cerber-os/MegaLeaf/README.md

# MegaLeaf - next level RGB lightning

## Overview

## Microcontroller

## Userspace software
