cerber-os/MegaLeaf/mcu_esperif/main/cfg/Readme.txt

Put here onboarding_cfg.json and device_info.json dowloaded from your project page on Samsung SmartThings Worspace.
