cerber-os/MegaLeaf/board/MegaLeafPCB.kicad_pcb

## KiCad design board/MegaLeafPCB.kicad_pcb (2022-11-14)

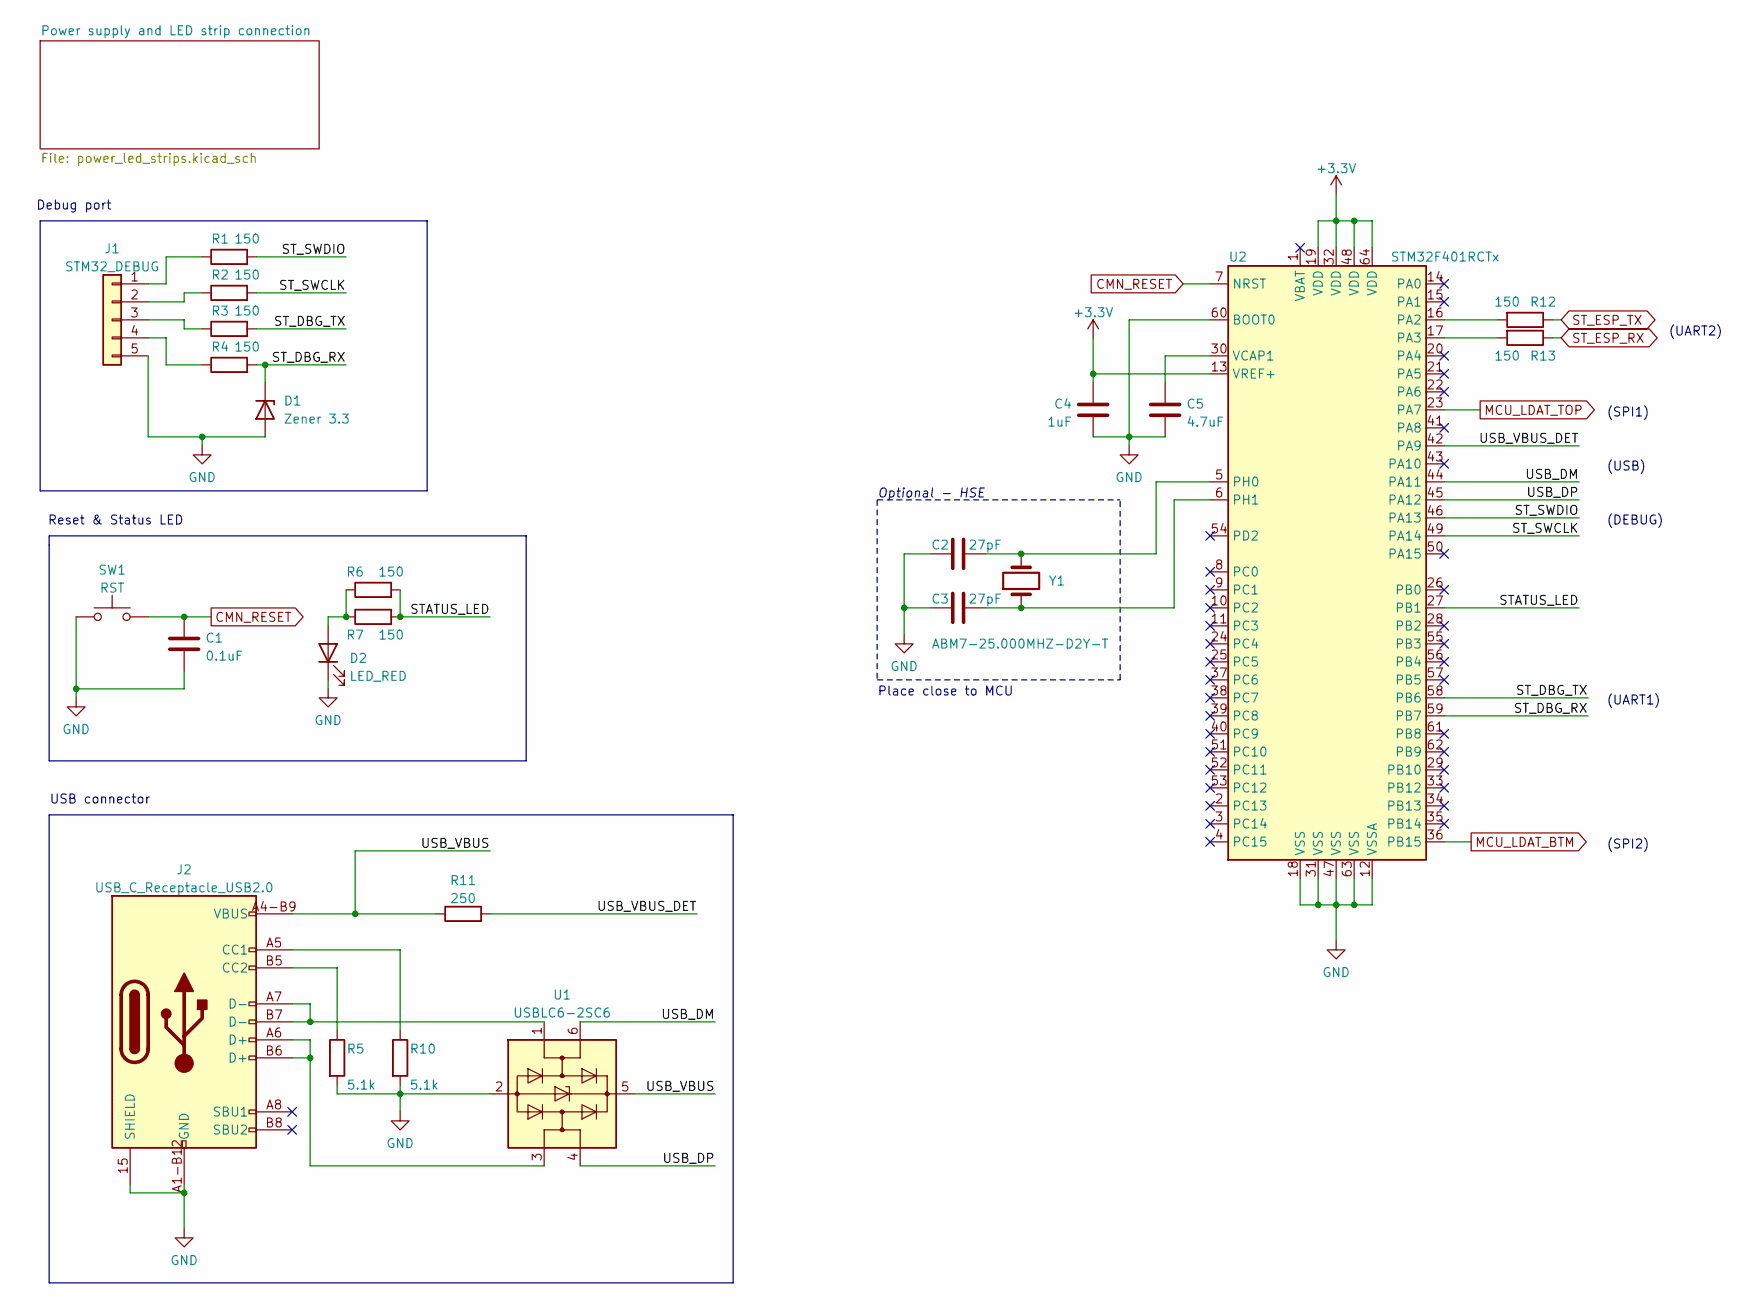
[picture p6: schematic MegaLeafPCB.kicad_sch, MegaLeaf Controller]

Parts:
C1: 0.1uF; C_0805_2012Metric_Pad1.18x1.45mm_HandSolder
C2, C3: 27pF; C_0603_1608Metric_Pad1.08x0.95mm_HandSolder
C4: 1uF; C_0805_2012Metric_Pad1.18x1.45mm_HandSolder
C5: 4.7uF; C_0805_2012Metric_Pad1.18x1.45mm_HandSolder
D1: Zener 3.3; SOT-23_Handsoldering
D2: LED_RED; D_0805_2012Metric_Pad1.15x1.40mm_HandSolder
J1: STM32_DEBUG; PinHeader_1x05_P2.54mm_Vertical_SMD_Pin1Left
J2: USB_C_Receptacle_USB2.0; USB4110-GF-A
R1, R2, R3, R4, R6, R7, R12, R13: 150; R_0805_2012Metric_Pad1.20x1.40mm_HandSolder
R5, R10: 5.1k; R_0805_2012Metric_Pad1.20x1.40mm_HandSolder
R11: 250; R_0805_2012Metric_Pad1.20x1.40mm_HandSolder
SW1: RST; SW_SPST_B3S-1000
U1: USBLC6-2SC6; SOT-23-6
U2: STM32F401RCTx; LQFP-64_10x10mm_P0.5mm
Y1: ABM7-25.000MHZ-D2Y-T; Crystal_SMD_Abracon_ABM7-2Pin_6.0x3.5mm

Connections:
+3.3V: C4.2, U2.13 (VREF+), U2.19 (VDD), U2.32 (VDD), U2.48 (VDD), U2.64 (VDD); also elsewhere on the board
/STATUS_LED: R6.2, R7.2, U2.27 (PB1)
/ST_DBG_RX: D1.1 (K), R4.2, U2.59 (PB7)
/ST_DBG_TX: R3.2, U2.58 (PB6)
/ST_SWCLK: R2.2, U2.49 (PA14)
/ST_SWDIO: R1.2, U2.46 (PA13)
/USB_DM: U1.6 (I/O1), U2.44 (PA11)
/USB_DP: U1.4 (I/O2), U2.45 (PA12)
/USB_VBUS: J2.A4-B9 (VBUS), J2.A9-B4 (VBUS), R11.1, U1.5 (VBUS)
/USB_VBUS_DET: R11.2, U2.42 (PA9)
CMN_RESET: C1.1, SW1.2, U2.7 (NRST); also elsewhere on the board
GND: C1.2, C2.1, C3.1, C4.1, C5.2, D1.2 (A), D2.1 (K), J1.5, J2.15 (SHIELD), J2.16 (SHIELD), J2.17 (SHIELD), J2.18 (SHIELD), J2.A1-B12 (GND), J2.A12-B1 (GND), R5.2, R10.2, SW1.1, U1.2 (GND), U2.12 (VSSA), U2.18 (VSS), U2.31 (VSS), U2.47 (VSS), U2.60 (BOOT0), U2.63 (VSS); also elsewhere on the board
MCU_LDAT_BTM: U2.36 (PB15); also elsewhere on the board
MCU_LDAT_TOP: U2.23 (PA7); also elsewhere on the board
unnamed: C2.2, U2.5 (PH0), Y1.2
unnamed: C3.2, U2.6 (PH1), Y1.1
unnamed: C5.1, U2.30 (VCAP1)
unnamed: D2.2 (A), R6.1, R7.1
unnamed: J1.1, R1.1
unnamed: J1.2, R2.1
unnamed: J1.3, R3.1
unnamed: J1.4, R4.1
unnamed: J2.A5 (CC1), R10.1
unnamed: J2.A6 (D+), J2.B6 (D+), U1.3 (I/O2)
unnamed: J2.A7 (D-), J2.B7 (D-), U1.1 (I/O1)
unnamed: J2.B5 (CC2), R5.1
unnamed: R12.2, U2.16 (PA2)
unnamed: R13.2, U2.17 (PA3)
ST_ESP_RX: R13.1; also elsewhere on the board
ST_ESP_TX: R12.1; also elsewhere on the board

Notes on the sheet:
(UART2)
Optional - HSE
(SPI2)
Reset & Status LED
(UART1)
Debug port
(SPI1)
(USB)
(DEBUG)
Place close to MCU
USB connector

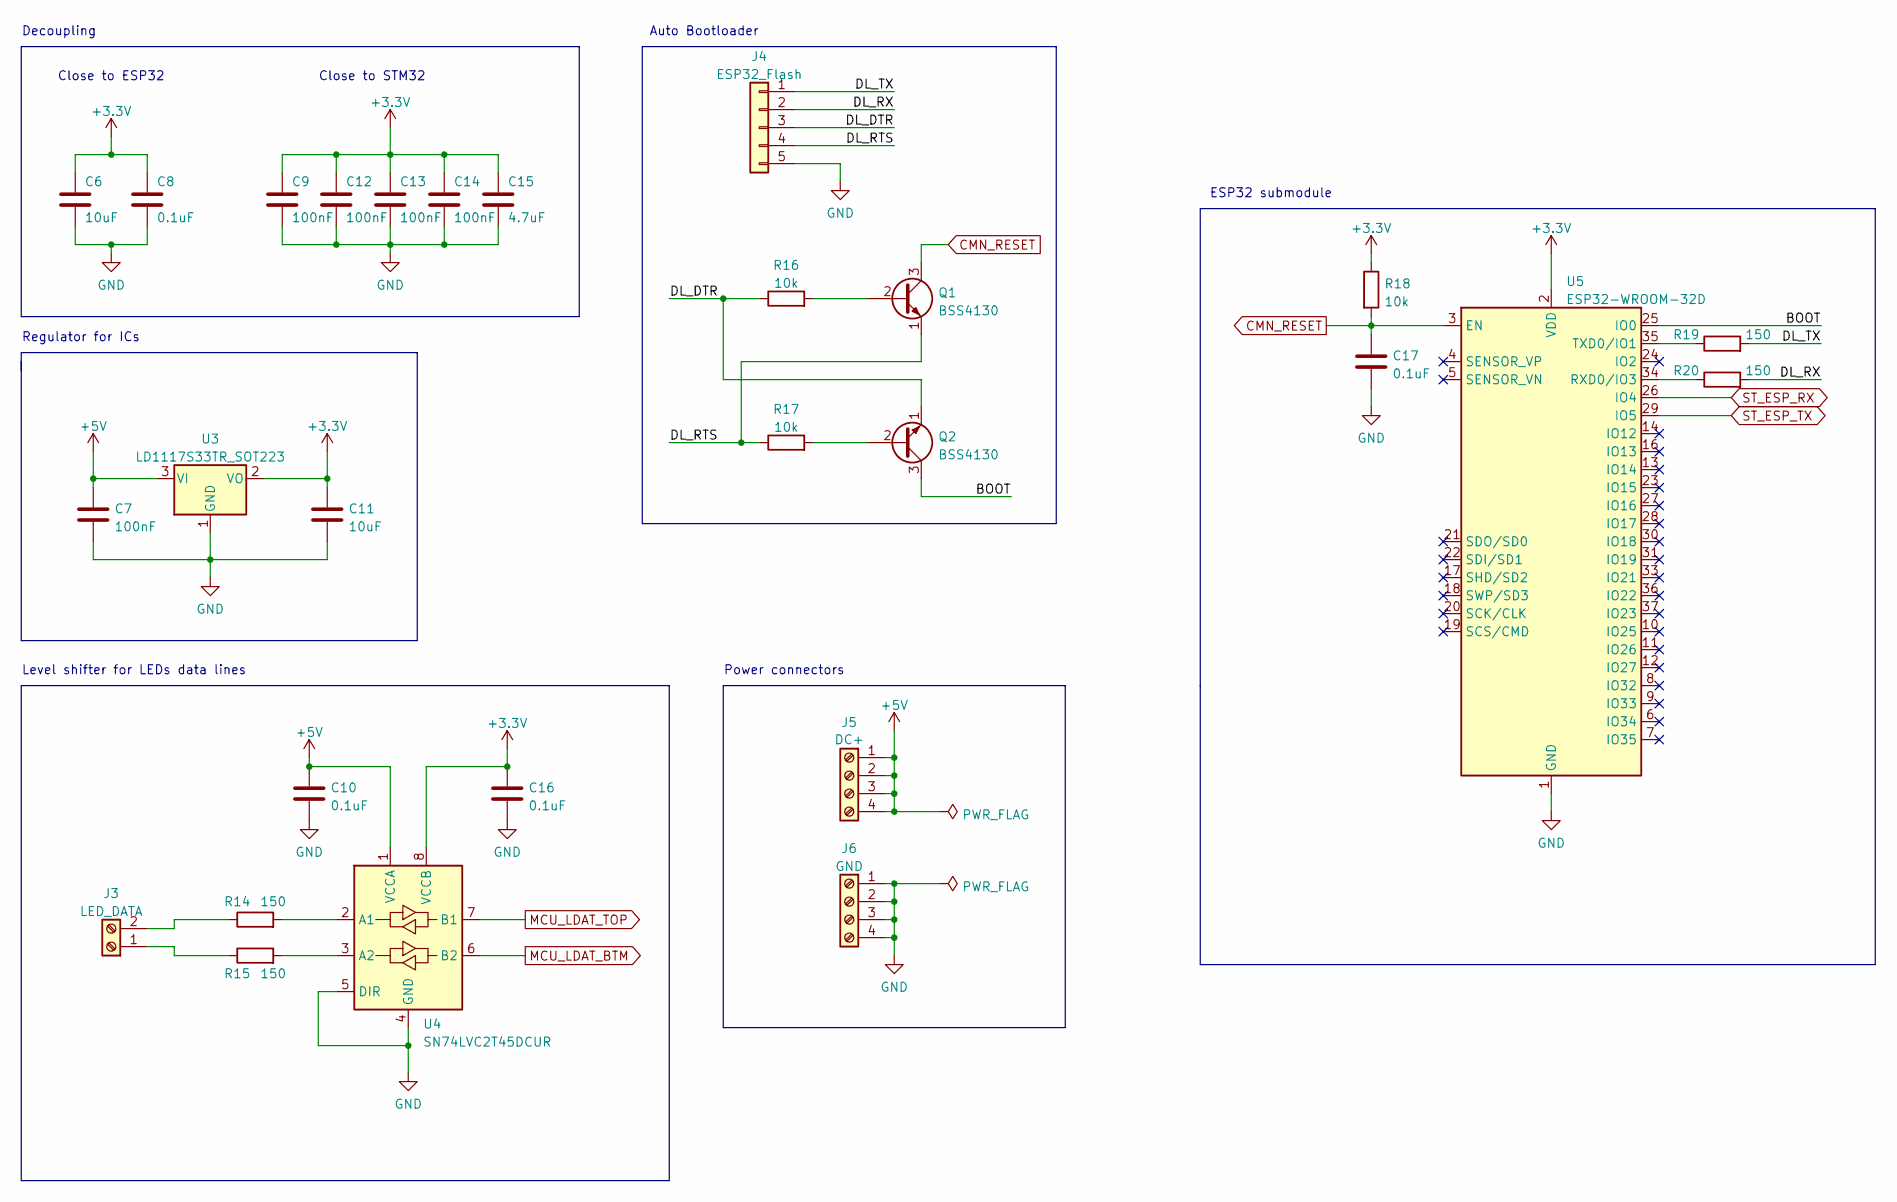
[picture p7: schematic power_led_strips.kicad_sch, MegaLeaf Controller]

Parts:
C6, C11: 10uF; C_0805_2012Metric_Pad1.18x1.45mm_HandSolder
C7, C9, C12, C13, C14: 100nF; C_0805_2012Metric_Pad1.18x1.45mm_HandSolder
C8, C10, C16, C17: 0.1uF; C_0805_2012Metric_Pad1.18x1.45mm_HandSolder
C15: 4.7uF; C_0805_2012Metric_Pad1.18x1.45mm_HandSolder
J3: LED_DATA; TerminalBlock_Phoenix_MKDS-1,5-2_1x02_P5.00mm_Horizontal
J4: ESP32_Flash; PinHeader_1x05_P2.54mm_Vertical_SMD_Pin1Left
J5: DC+; MC000020
J6: GND; MC000020
Q1, Q2: BSS4130; SOT-23
R14, R15, R19, R20: 150; R_0805_2012Metric_Pad1.20x1.40mm_HandSolder
R16, R17, R18: 10k; R_0805_2012Metric_Pad1.20x1.40mm_HandSolder
U3: LD1117S33TR_SOT223; SOT-223-3_TabPin2
U4: SN74LVC2T45DCUR; VSSOP-8_2.4x2.1mm_P0.5mm
U5: ESP32-WROOM-32D; ESP32-WROOM-32

Connections:
+3.3V: C6.1, C8.1, C9.1, C11.1, C12.1, C13.1, C14.1, C15.1, C16.1, R18.1, U3.2 (VO), U4.8 (VCCB), U5.2 (VDD); also elsewhere on the board
+5V: C7.1, C10.1, J5.1, J5.2, J5.3, J5.4, U3.3 (VI), U4.1 (VCCA)
/Power supply and LED strip connection/BOOT: Q2.3 (C), U5.25 (IO0)
/Power supply and LED strip connection/DL_DTR: J4.3, Q2.1 (E), R16.1
/Power supply and LED strip connection/DL_RTS: J4.4, Q1.1 (E), R17.1
/Power supply and LED strip connection/DL_RX: J4.2, R20.2
/Power supply and LED strip connection/DL_TX: J4.1, R19.2
CMN_RESET: C17.1, Q1.3 (C), R18.2, U5.3 (EN); also elsewhere on the board
GND: C6.2, C7.2, C8.2, C9.2, C10.2, C11.2, C12.2, C13.2, C14.2, C15.2, C16.2, C17.2, J4.5, J6.1, J6.2, J6.3, J6.4, U3.1 (GND), U4.4 (GND), U4.5 (DIR), U5.1 (GND), U5.15 (GND), U5.38 (GND), U5.39 (GND); also elsewhere on the board
MCU_LDAT_BTM: U4.6 (B2); also elsewhere on the board
MCU_LDAT_TOP: U4.7 (B1); also elsewhere on the board
unnamed: J3.1, R15.1
unnamed: J3.2, R14.1
unnamed: Q1.2 (B), R16.2
unnamed: Q2.2 (B), R17.2
unnamed: R14.2, U4.2 (A1)
unnamed: R15.2, U4.3 (A2)
unnamed: R19.1, U5.35 (TXD0/IO1)
unnamed: R20.1, U5.34 (RXD0/IO3)
ST_ESP_RX: U5.26 (IO4); also elsewhere on the board
ST_ESP_TX: U5.29 (IO5); also elsewhere on the board

Notes on the sheet:
Decoupling
ESP32 submodule
Regulator for ICs
Auto Bootloader
Power connectors
Close to STM32
Close to ESP32
Level shifter for LEDs data lines

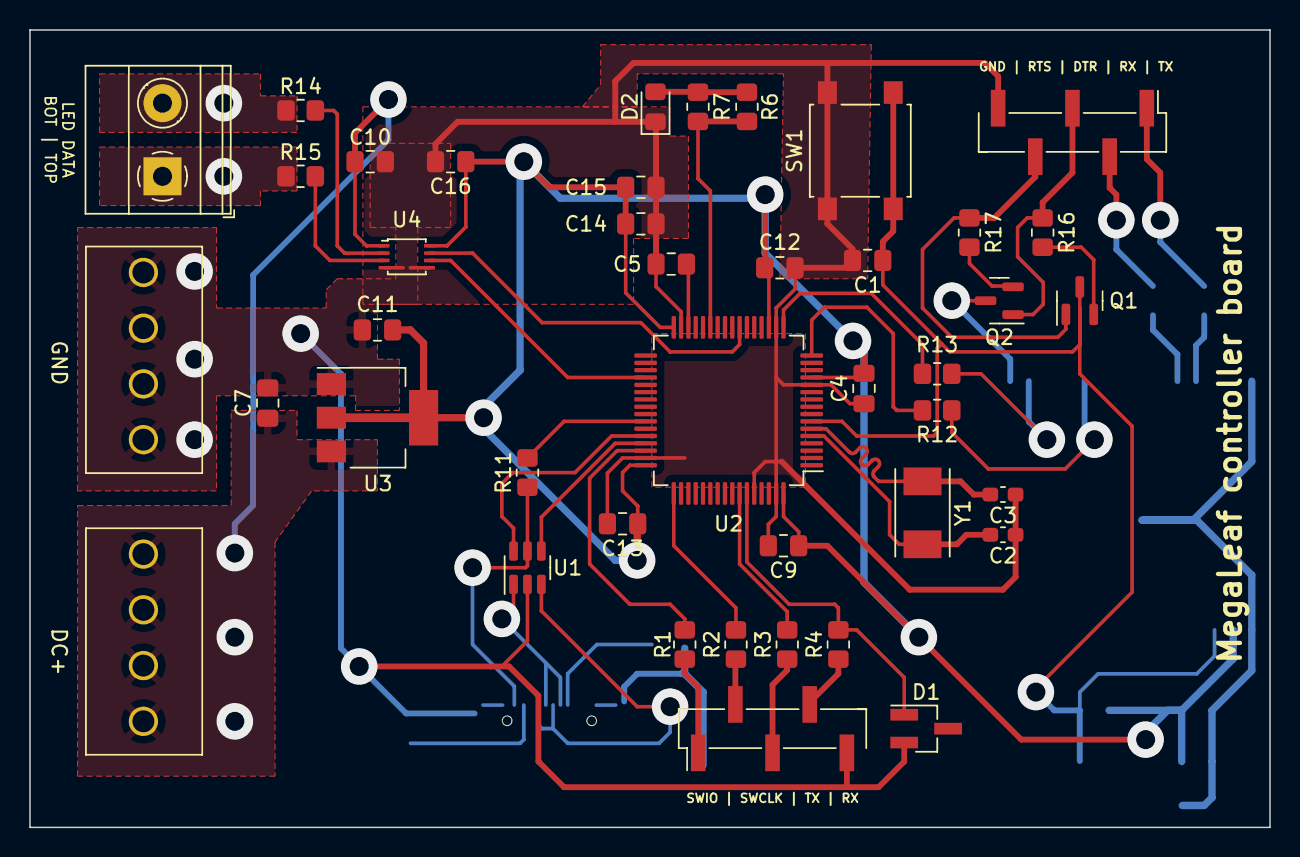
[picture p8: board MegaLeafPCB.kicad_pcb from above]

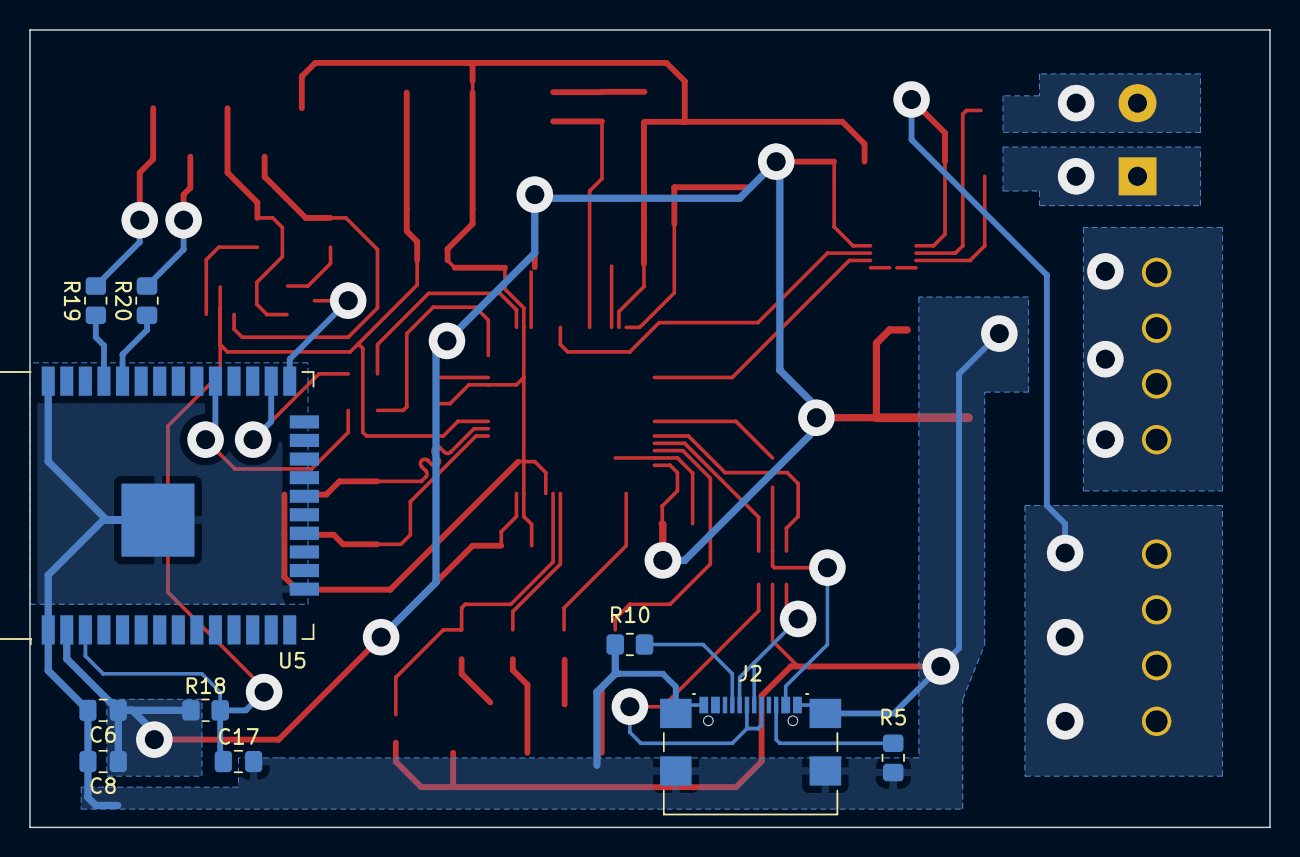
[picture p9: board MegaLeafPCB.kicad_pcb from below]

Board: 2 copper layers, 84.8 x 54.5 mm, 52 parts (10 on the bottom side), 44 nets.
