cerber-os/MegaLeaf/mcu_stm32/Core/Src/main.c

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
/* Includes ------------------------------------------------------------------*/
#include "main.h"
#include "usb_device.h"

/* USER CODE BEGIN Includes */
#include "logger.h"
#include "panic.h"
#include "app.h"
#include "boot_setup.h"
#include <stdio.h>
/* USER CODE END Includes */

 IWDG_HandleTypeDef hiwdg;

SPI_HandleTypeDef hspi1;
SPI_HandleTypeDef hspi2;
DMA_HandleTypeDef hdma_spi1_tx;
DMA_HandleTypeDef hdma_spi2_tx;

UART_HandleTypeDef huart1;
UART_HandleTypeDef huart2;

void SystemClock_Config(void);
static void MX_GPIO_Init(void);
static void MX_DMA_Init(void);
static void MX_USART1_UART_Init(void);
static void MX_USART2_UART_Init(void);
static void MX_SPI1_Init(void);
static void MX_SPI2_Init(void);
static void MX_IWDG_Init(void);
/**
  * @brief  The application entry point.
  * @retval int
  */
int main(void)
{
  /* MCU Configuration--------------------------------------------------------*/

  /* Reset of all peripherals, Initializes the Flash interface and the Systick. */
  HAL_Init();

  /* Configure the system clock */
  SystemClock_Config();

  /* USER CODE BEGIN SysInit */
  boot_save_reset_reason();
  /* USER CODE END SysInit */

  /* Initialize all configured peripherals */
  MX_GPIO_Init();
  MX_DMA_Init();
  MX_USART1_UART_Init();
  MX_USART2_UART_Init();
  MX_SPI1_Init();
  MX_SPI2_Init();
  MX_IWDG_Init();
  MX_USB_DEVICE_Init();
  /* USER CODE BEGIN 2 */

  puts("\n");
  printk(LOG_WARNING "======= RESET =======");
  printk(LOG_INFO "Reset caused by: %s", boot_get_reset_reason_str());
  printk(LOG_INFO "MegaLeaf controller v1.1.1");
  printk(LOG_INFO "* Subversion: %s", "04df3a-dirty");
  printk(LOG_INFO "* REVID: 0x%x", HAL_GetREVID());
  printk(LOG_INFO "* DEVID: 0x%x", HAL_GetDEVID());
  printk(LOG_INFO "* UID:   %08x-%08x-%08x", HAL_GetUIDw0(), HAL_GetUIDw1(), HAL_GetUIDw2());
  printk(LOG_INFO "Starting app...");

  app_init();
  app_main_loop();

  panic("Application has been unexpectedly terminated");

  /* USER CODE END 2 */

  /* Infinite loop */
  /* USER CODE BEGIN WHILE */
  while (1)
  {
    /* USER CODE END WHILE */

    /* USER CODE BEGIN 3 */
  }
  /* USER CODE END 3 */
}

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
/* USER CODE BEGIN 4 */
int __io_putchar(int ch) {
	if(ch == '\n') {
		ch = '\r';
		HAL_UART_Transmit(&huart1, (uint8_t*) &ch, 1, 1000);
		ch = '\n';
	}
	return HAL_UART_Transmit(&huart1, (uint8_t*) &ch, 1, 1000);
}

int __io_getchar(void) {
	unsigned char ch = '\0';

	HAL_UART_Receive(&huart1, &ch, sizeof(ch), 1000);
	return ch;
}
/* USER CODE END 4 */
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
