cerber-os/MegaLeaf/mcu_stm32/MegaLeaf_STM32F4.ioc

Mcu.UserName=STM32F401RCTx
PA11.Signal=USB_OTG_FS_DM
PA12.Signal=USB_OTG_FS_DP
PA13.Signal=SYS_JTMS-SWDIO
PA14.Signal=SYS_JTCK-SWCLK
PA2.GPIO_Label=ST_ESP_TX
PA2.Signal=USART2_TX
PA3.GPIO_Label=ST_ESP_RX
PA3.Signal=USART2_RX
PA5.Signal=SPI1_SCK
PA7.Signal=SPI1_MOSI
PA9.Signal=USB_OTG_FS_VBUS
PB1.GPIO_Label=STATUS_LED
PB1.Signal=GPIO_Output
PB10.Signal=SPI2_SCK
PB15.GPIO_Label=MCU_LDAT_BTM
PB15.Signal=SPI2_MOSI
PB6.GPIO_Label=ST_DBG_TX
PB6.Signal=USART1_TX
PB7.GPIO_Label=ST_DBG_RX
PB7.Signal=USART1_RX
