cerber-os/MegaLeaf/mcu_stm32/Core/Inc/main.h

#define ST_ESP_TX_Pin GPIO_PIN_2
#define ST_ESP_TX_GPIO_Port GPIOA
#define ST_ESP_RX_Pin GPIO_PIN_3
#define ST_ESP_RX_GPIO_Port GPIOA
#define STATUS_LED_Pin GPIO_PIN_1
#define STATUS_LED_GPIO_Port GPIOB
#define MCU_LDAT_BTM_Pin GPIO_PIN_15
#define MCU_LDAT_BTM_GPIO_Port GPIOB
#define ST_DBG_TX_Pin GPIO_PIN_6
#define ST_DBG_TX_GPIO_Port GPIOB
#define ST_DBG_RX_Pin GPIO_PIN_7
#define ST_DBG_RX_GPIO_Port GPIOB
