cerber-os/MegaLeaf/(commit log)

2022-06-23 [MCU] Add support for custom colors command
    Update STM32CubeMX revision
2022-06-23 [MCU] Fix transmission errors caused by unexpected interrupts
    [ws2812b.c]
2022-11-14 [MCU] Convert to STM32F4 microcontroller
2022-11-14 [SCH] Upload KiCad schematic files
    [MegaLeafPCB.kicad_pcb, MegaLeafPCB.kicad_sch, power_led_strips.kicad_sch]
2022-11-25 [ESP] Upload code for ESP32 board
2022-11-25 [Win] Update Windows app
    * Add NotifyIcon in tray bar for easier control
    * Support right-click menu on this icon
    * Allow process to close cmd window and enter background
    * Add cmdline arguments parsing
    * Improve error handling in Desktop Duplication API
    [AmbiLights.cpp, AmbiLights.hpp, ArgsParsing.cpp, ArgsParsing.hpp, DesktopDuplication.cpp, DesktopDuplicationAPI.h, main.cpp]
2022-11-25 [MCU] Fix incorrect rounding of brightness
    [app.c]
2022-11-25 [MCU] Fix progress bar effect
    [mlf_effects.c]
2023-01-05 [Board] Update README.md
2023-05-24 [ESP] Fix state synchronization over USB
    [main.cpp, mlf_comm.c]
2023-05-24 [Win] Fix handling leds state from context menu
    [AmbiLights.cpp, AmbiLights.hpp]
2023-08-14 [ESP] Fix building project outside of st-device-sdk-c repo
    Improve CMakeLists.txt and other build files so that project can be
    built with idf.py without need to embed it into st-device-sdk-c
    repository
    [custom_partitions.csv]
2023-08-14 Add st-device-sdk-c repository as submodule
