cerber-os/MegaLeaf/(notices)

Notices in the files:
mcu_stm32/Core/Src/main.c:
Copyright (c) 2022 STMicroelectronics.
All rights reserved.
This software is licensed under terms that can be found in the LICENSE file
parts and their libraries:
Copyright 2021 Accelerated Designs. All rights reserved.
